ozdemirsalih/Casio-Cheat-Calculator/Casio-Cheating-Calculator/Casio-Cheating-Calculator.ino

/*
There's no license, you're free to use this code as you wish.
-Salih Özdemir 2024
*/
/*
There's a total of 95 buttons mapped into the "writeCharToDisplay()" function, as listed below;
1⟷1 | 2⟷2 | 3⟷3 | 4⟷+ | 5⟷- | 6⟷= | 7⟷4 | 8⟷5 | 9⟷6 | 10⟷*
11⟷/ | 12⟷Ans | 13⟷7 | 14⟷8 | 15⟷9 | 16⟷DEL | 17⟷AC | 18⟷EXP | 19⟷RCL | 20⟷ENG
21⟷( | 22⟷) | 23⟷, | 24⟷M+ | 25⟷. | 26⟷(-) | 27⟷°,,, | 28⟷hyp | 29⟷sin | 30⟷cos
31⟷tan | 32⟷0 | 33⟷a(b/c) | 34⟷√ | 35⟷x^2 | 36⟷^ | 37⟷log | 38⟷ln | 39⟷x^-1 | 40⟷nCr
41⟷left | 42⟷down | 43⟷Pol( | 44⟷x^3 | 45⟷SHIFT | 46⟷ALPHA | 47⟷up | 48⟷right | 49⟷MODE | 50⟷CLR
51⟷x! | 52⟷nPr | 53⟷Rec( | 54⟷3√ | 55⟷d/c | 56⟷x√ | 57⟷10^x | 58⟷e^x | 59⟷sin^-1 | 60⟷cos^-1
61⟷tan^-1 | 62⟷STO | 63⟷; | 64⟷M- | 65⟷INS | 66⟷S-SUM | 67⟷S-VAR | 68⟷Rnd | 69⟷Ran# | 70⟷π
71⟷DRG> | 72⟷% | 73⟷: | 74⟷e | 75⟷A | 76⟷B | 77⟷C | 78⟷D | 79⟷E | 80⟷F
81⟷X | 82⟷Y | 83⟷M | 84⟷left arrow above °,,, | 85⟷left arrow above ENG | 86⟷OFF | 87⟷G of DRG> | 88⟷R of DRG> | 89⟷D of DRG> | 90⟷sinh
91⟷cosh | 92⟷tanh | 93⟷sinh^-1 | 94⟷cosh^-1 | 95⟷tanh^-1
*/
//I2C Library for communicating with the BMX055.
#include<Wire.h>
//Libraries for the websocket server.
#include <ESP8266WiFi.h>
#include <ESPAsyncTCP.h>
#include <ESPAsyncWebServer.h>
//I2C pins of the ESP8285.
#define SDA_PIN 4
#define SCL_PIN 5
// BMX055 Accelerometer I2C address.
#define Addr_Accl 0x18
// BMX055 Gyroscope I2C address.
#define Addr_Gyro 0x68
// BMX055 Magnetometer I2C address.
#define Addr_Mag 0x10
//Variables for receiving/sending data from/to the BMX055.
unsigned long milliscountforbmx;
uint8_t accelfifocountbyte;
uint8_t accelfifocount;
uint8_t acceldata[193];
uint8_t responsebytefrombmxconfig;
int indexofminusinconfigstr;
String substrforbmxconfig1;
String substrforbmxconfig2;
//Network SSID & Password.
const char* ssid = "my_calculator";
const char* password = "123456789";
//The string that holds the local IP address of the ESP8285.
String localIPAddressString;
//Creating AsyncWebServer object on port 80.
AsyncWebServer server(80);
AsyncWebSocket ws("/ws");
//The HTML content for the server(stored in the PROGMEM).
const char index_html[] PROGMEM = R"rawliteral(
<!DOCTYPE HTML>
<html>
  <head>
    <style>
      @font-face {
        font-family:'casioFont';
        src: url('data:font/ttf;charset=utf-8;base64,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\
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
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
void loop() {
  //By setting the S input of the SN74LVC1G3157 to LOW and HIGH after, the connection between the selected KIx & KOx is established, hence the button press is simulated.
  //The 50ms delays are used between these 'digitalWrite's to ensure the fx-82MS can detect the desired button press.
  //Executing the "digitalWrite()" funtions with 50ms delays using "millis()".
  if (emulatebuttonpressflag) {
    if (milliscount1recorded) {
      if (millis()-milliscount1>49) {
        if (milliscount2recorded) {
          if (millis()-milliscount2>49) {
            //This funcion needs to be called in order to websocket server to properly keep track of the connected clients.
            ws.cleanupClients();
            //Setting the booleans to their default values.
            milliscount1recorded=false;
            milliscount2recorded=false;
            emulatebuttonpressflag=false;
            //Checking "charqueue" array if there're more characters to write onto the fx-82MS calculator's display.
            checkQueue();
          }
        }
        else {
          milliscount2=millis();
          milliscount2recorded=true;
          digitalWrite(spin, HIGH);
        }
      }
    }
    else {
      milliscount1=millis();
      milliscount1recorded=true;
      digitalWrite(spin, LOW);
    }
  }
  //Getting BMX055 data every 16ms from the FIFO, and sending it to the clients as binary over websocket connection.
  if (millis()-milliscountforbmx>15) {
    milliscountforbmx=millis();
    Wire.beginTransmission(Addr_Accl);
    Wire.write(0x0E);
    Wire.endTransmission();
    Wire.requestFrom(Addr_Accl, 1);
    if (Wire.available() == 1) {
      accelfifocount = Wire.read();
      accelfifocountbyte=(accelfifocount & 0x7F)*6;
      if (accelfifocountbyte>0) {
        Wire.beginTransmission(Addr_Accl);
        Wire.write(0x3F);
        Wire.endTransmission();
        Wire.requestFrom(Addr_Accl, accelfifocountbyte);
        if (Wire.available() == accelfifocountbyte) {
          acceldata[0]=accelfifocountbyte;
          for (k=0; k<accelfifocountbyte; k++) {
            acceldata[k+1] = Wire.read();
          }
          accelfifocountbyte++;
          ws.binaryAll(acceldata, accelfifocountbyte);
        }
      }
    }
  }
}
//This function handles the incoming data to the websocket server.
//The "~" character is being send back to the specific client for the latecy test.
//The "s" character means a deep sleep command has been received.
//The "p" character means a restart command has been received.
//The first character "w" means write to BMX055 for configuration.
//The first character "r" means read configuration value from the BMX055.
//The second character "a" means use accelerometer address for configurations.
//The second character "g" means use gyroscope address for configurations.
//The second character "m" means use magnetometer address for configurations.
void handleWebSocketMessage(void *arg, uint8_t *data, size_t len, AsyncWebSocketClient *client) {
  AwsFrameInfo *info = (AwsFrameInfo*)arg;
  if (info->final && info->index == 0 && info->len == len && info->opcode == WS_TEXT) {
    data[len] = 0;
    receivedmessagestring=(char*)data;
    if (receivedmessagestring.charAt(0)=='w') {
      indexofminusinconfigstr=receivedmessagestring.indexOf('x');
      substrforbmxconfig1=receivedmessagestring.substring(2,(indexofminusinconfigstr+1));
      substrforbmxconfig2=receivedmessagestring.substring((indexofminusinconfigstr+1));
      if (receivedmessagestring.charAt(1)=='a') {
        Wire.beginTransmission(Addr_Accl);
        Wire.write(substrforbmxconfig1.toInt());
        Wire.write(substrforbmxconfig2.toInt());
        Wire.endTransmission();
        ws.textAll(receivedmessagestring);
      }
      else if (receivedmessagestring.charAt(1)=='g') {
        Wire.beginTransmission(Addr_Gyro);
        Wire.write(substrforbmxconfig1.toInt());
        Wire.write(substrforbmxconfig2.toInt());
        Wire.endTransmission();
        ws.textAll(receivedmessagestring);
      }
      else if (receivedmessagestring.charAt(1)=='m') {
        Wire.beginTransmission(Addr_Mag);
        Wire.write(substrforbmxconfig1.toInt());
        Wire.write(substrforbmxconfig2.toInt());
        Wire.endTransmission();
        ws.textAll(receivedmessagestring);
      }
    }
    else if (receivedmessagestring.charAt(0)=='r') {
      substrforbmxconfig1=receivedmessagestring.substring(2);
      if (receivedmessagestring.charAt(1)=='a') {
        Wire.beginTransmission(Addr_Accl);
        Wire.write(substrforbmxconfig1.toInt());
        Wire.endTransmission();
        Wire.requestFrom(Addr_Accl, 1);
        if (Wire.available() == 1) {
          responsebytefrombmxconfig = Wire.read();
          client->text(receivedmessagestring+"-"+String(responsebytefrombmxconfig));
        }
      }
      else if (receivedmessagestring.charAt(1)=='g') {
        Wire.beginTransmission(Addr_Gyro);
        Wire.write(substrforbmxconfig1.toInt());
        Wire.endTransmission();
        Wire.requestFrom(Addr_Gyro, 1);
        if (Wire.available() == 1) {
          responsebytefrombmxconfig = Wire.read();
          client->text(receivedmessagestring+"-"+String(responsebytefrombmxconfig));
        }
      }
      else if (receivedmessagestring.charAt(1)=='m') {
        Wire.beginTransmission(Addr_Mag);
        Wire.write(substrforbmxconfig1.toInt());
        Wire.endTransmission();
        Wire.requestFrom(Addr_Mag, 1);
        if (Wire.available() == 1) {
          responsebytefrombmxconfig = Wire.read();
          client->text(receivedmessagestring+"-"+String(responsebytefrombmxconfig));
        }
      }
    }
    else if (receivedmessagestring=="~") {
      client->text("~");
    }
    else if (receivedmessagestring=="s") {
      ESP.deepSleep(0);
    }
    else if (receivedmessagestring=="p") {
      ESP.restart();
    }
    else {
      receivedmessageint=receivedmessagestring.toInt();
      if (emulatebuttonpressflag) {
        if (receivedmessageint>49 && receivedmessageint<96) {
          if (receivedmessageint==50){
            addCharToTheQueue(45);
            addCharToTheQueue(49);
          }
          else if (receivedmessageint==51){
            addCharToTheQueue(45);
            addCharToTheQueue(39);
          }
          else if (receivedmessageint==52){
            addCharToTheQueue(45);
            addCharToTheQueue(40);
          }
          else if (receivedmessageint==53){
            addCharToTheQueue(45);
            addCharToTheQueue(43);
          }
          else if (receivedmessageint==54){
            addCharToTheQueue(45);
            addCharToTheQueue(44);
          }
          else if (receivedmessageint==55){
            addCharToTheQueue(45);
            addCharToTheQueue(33);
          }
          else if (receivedmessageint==56){
            addCharToTheQueue(45);
            addCharToTheQueue(36);
          }
          else if (receivedmessageint==57){
            addCharToTheQueue(45);
            addCharToTheQueue(37);
          }
          else if (receivedmessageint==58){
            addCharToTheQueue(45);
            addCharToTheQueue(38);
          }
          else if (receivedmessageint==59){
            addCharToTheQueue(45);
            addCharToTheQueue(29);
          }
          else if (receivedmessageint==60){
            addCharToTheQueue(45);
            addCharToTheQueue(30);
          }
          else if (receivedmessageint==61){
            addCharToTheQueue(45);
            addCharToTheQueue(31);
          }
          else if (receivedmessageint==62){
            addCharToTheQueue(45);
            addCharToTheQueue(19);
          }
          else if (receivedmessageint==63){
            addCharToTheQueue(45);
            addCharToTheQueue(23);
          }
          else if (receivedmessageint==64){
            addCharToTheQueue(45);
            addCharToTheQueue(24);
          }
          else if (receivedmessageint==65){
            addCharToTheQueue(45);
            addCharToTheQueue(16);
          }
          else if (receivedmessageint==66){
            addCharToTheQueue(45);
            addCharToTheQueue(1);
          }
          else if (receivedmessageint==67){
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
      writeCharToDisplay(9);
    }
    else if (localIPAddressString.charAt(i3)=='7') {
      writeCharToDisplay(13);
    }
    else if (localIPAddressString.charAt(i3)=='8') {
      writeCharToDisplay(14);
    }
    else if (localIPAddressString.charAt(i3)=='9') {
      writeCharToDisplay(15);
    }
  }
}
