ozdemirsalih/Casio-Cheat-Calculator/(commit log)

2024-10-17 Added PCB design files
2024-10-17 Added assembled pictures of the device
